VikasCENG/WatechPark/Sensor Specific Code/Camera/image-testing/2020-01-30_0009.jpg

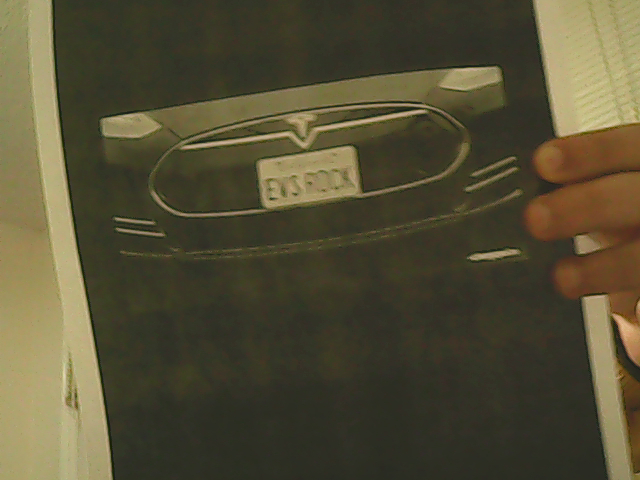
Sensor Specific Code/Camera/image-testing/2020-01-30_0009.jpg
