VikasCENG/WatechPark/README.md

# WatechPark
This is the WatechPark development repository
