VikasCENG/WatechPark/documentation/Seperated report sections/7.1 Finacial update.docx

As of March 3rd, there has not been a major financial change in the project’s cost. In our current situation and due to time limitation, the use of more than one VNCL4010 sensor has been dropped and thus reducing the overall cost by $22.5 USD, but on the other hand, if we had no time constraints then the original overall cost would’ve been increased by $6.95 USD as we would’ve required a TCA9548A I2C multiplexer board to allow us to communicate with multiple VCNL4010 sensors. We also had to switch from a common anode RGB LEDs to common cathode RGB LEDs, which has a very minor impact on the project financially.
