VikasCENG/WatechPark/documentation/Seperated report sections/7.1 Modified Code Files(will not be used).docx

VCNL4010

This sensor code has been simplified to make it easier to look and optimize its usage in the merged program. The status updates from multiple sensors has been removed as well to accommodate the project time limitation and focus on the main functionalities instead of the extra ones.

IR Break Beam Sensor
