VikasCENG/WatechPark/Parking Lot Design/WatechParkLotDesignLaser.pdf

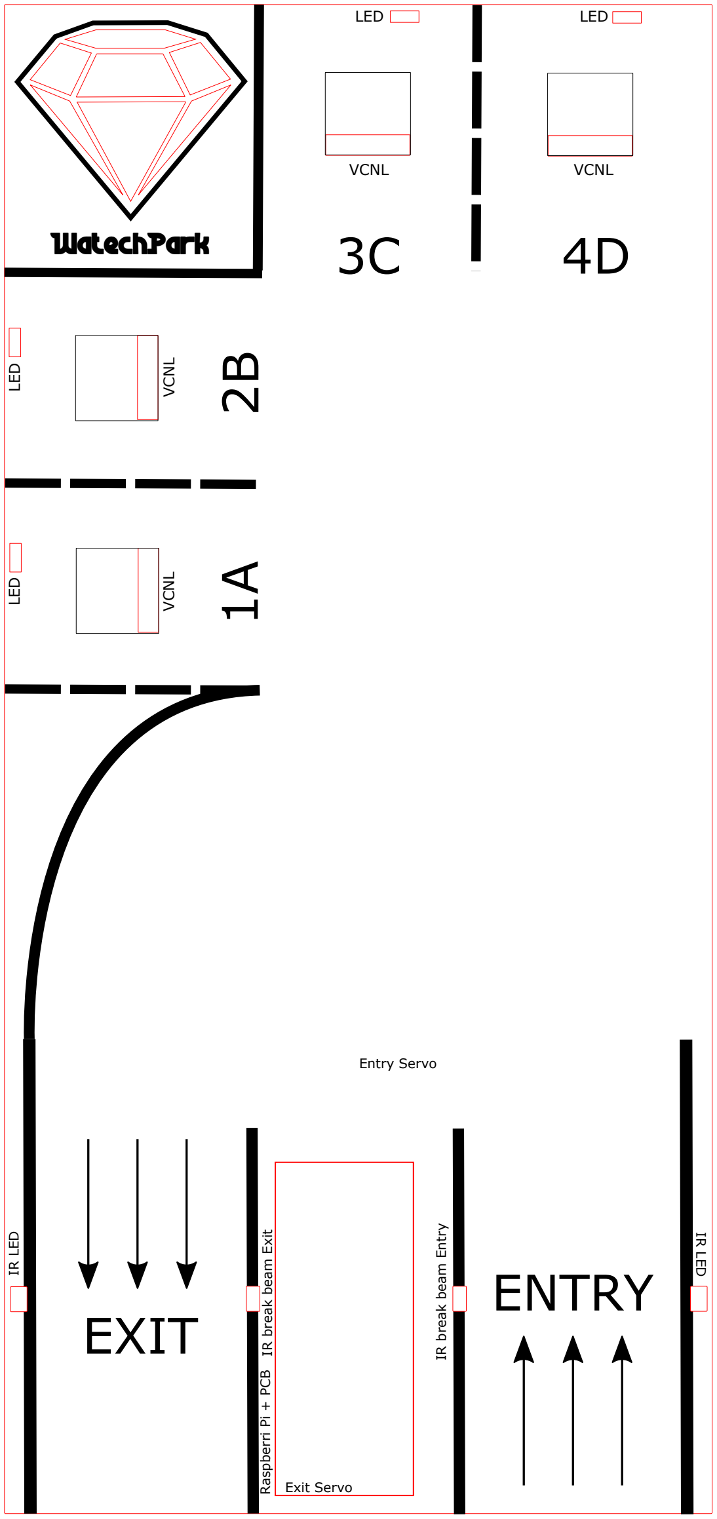
[picture p83: figure]
ENTRY; EXIT; WatechPark; VCNL; LED; Entry Servo; Raspberri Pi + PCB; Exit Servo; IR break beam Entry; IR break beam Exit; IR LED
