VikasCENG/WatechPark/Parking Lot Design/park v2(no logo).pdf

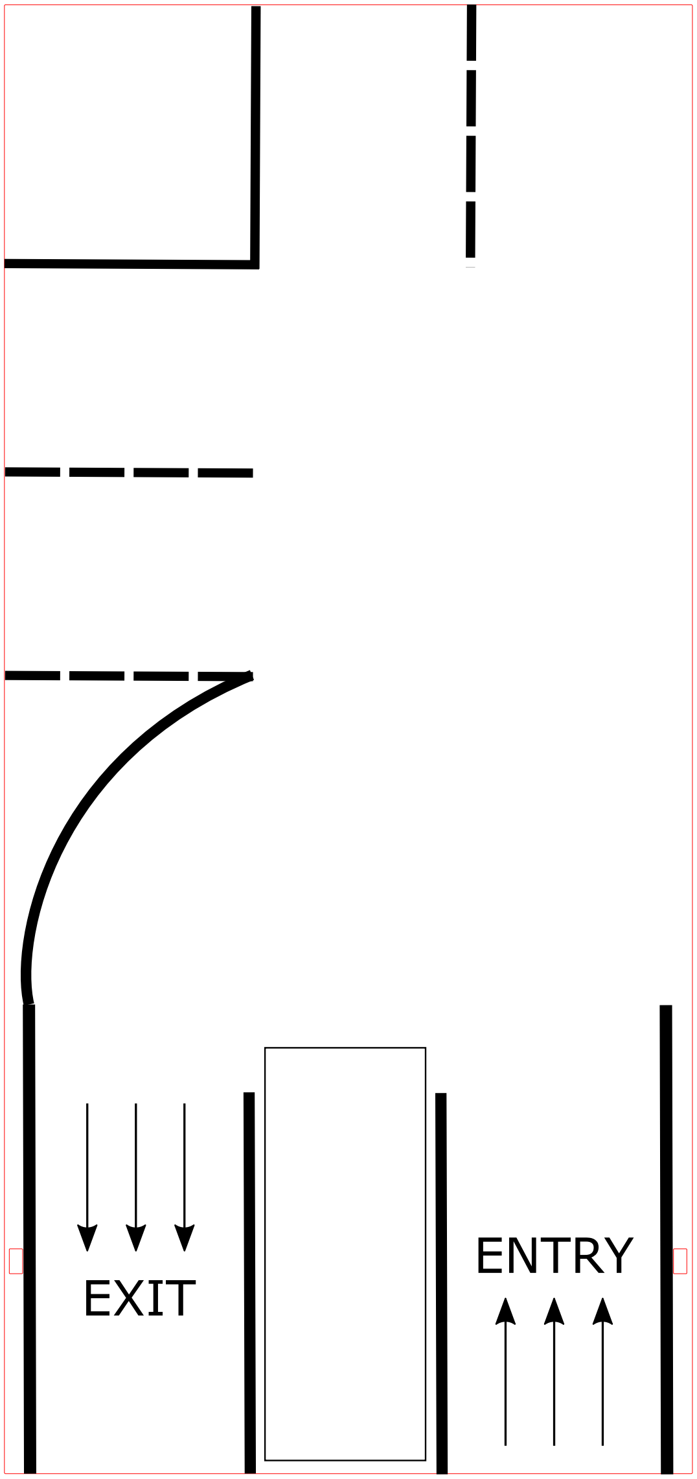
[picture p112: figure]
ENTRY; EXIT
