VikasCENG/WatechPark/documentation/Multimeter/PCB I2C.JPG

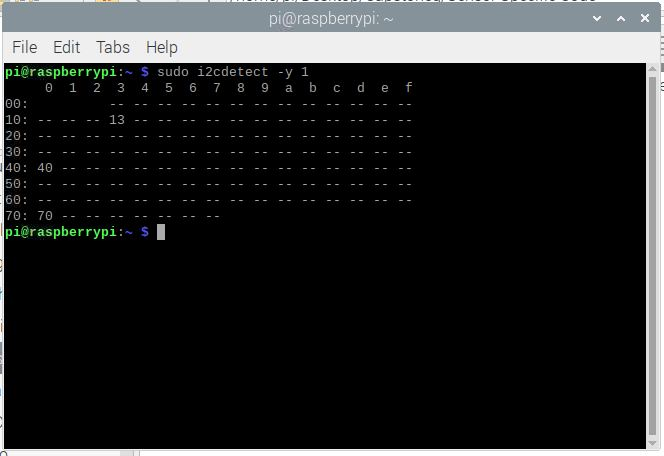
documentation/Multimeter/PCB I2C.JPG
