VikasCENG/WatechPark/documentation/Multimeter/Shortened PCB.JPG

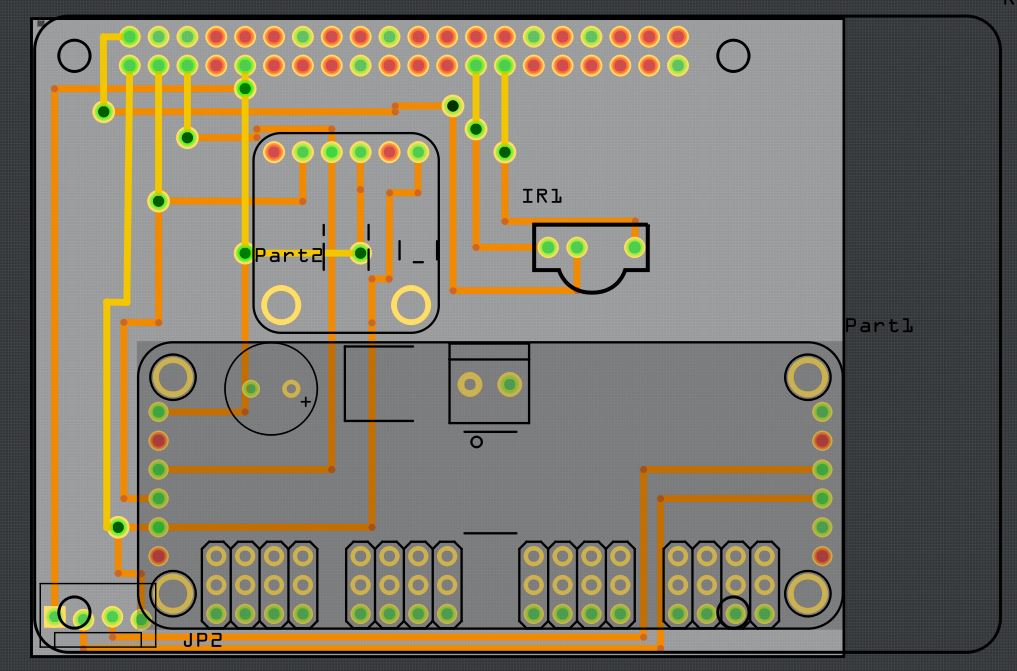
documentation/Multimeter/Shortened PCB.JPG
