VikasCENG/WatechPark/Images/3-3-2020/1.JPG

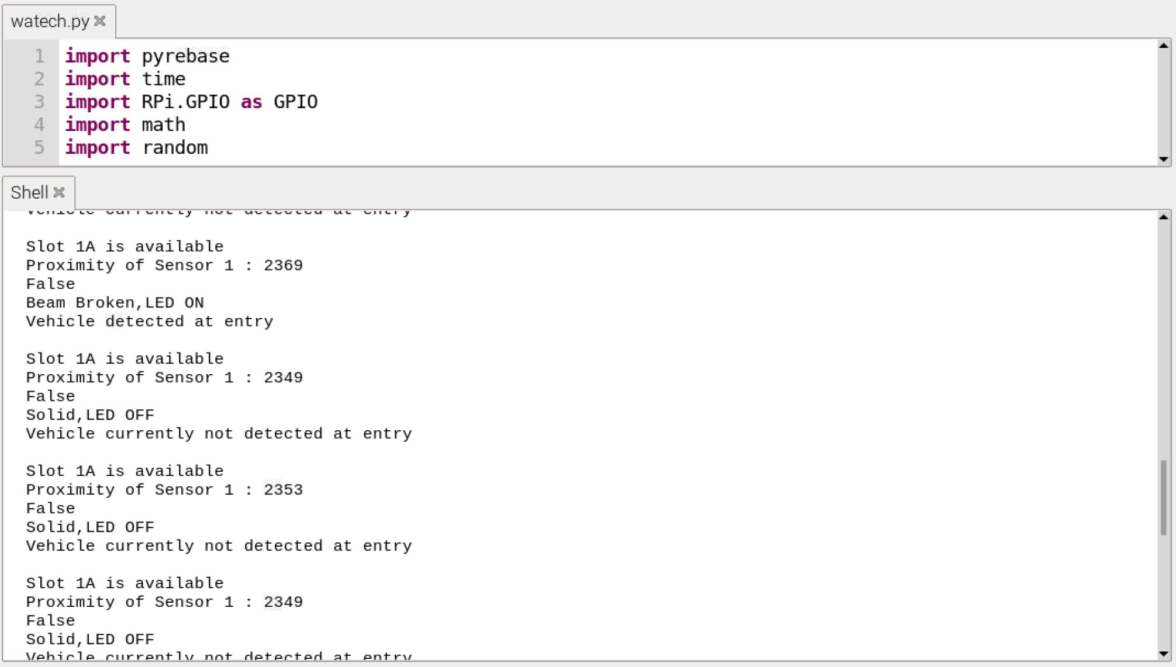
Images/3-3-2020/1.JPG
