VikasCENG/WatechPark/mechanical/WatechParkCaseDesignLaser.png

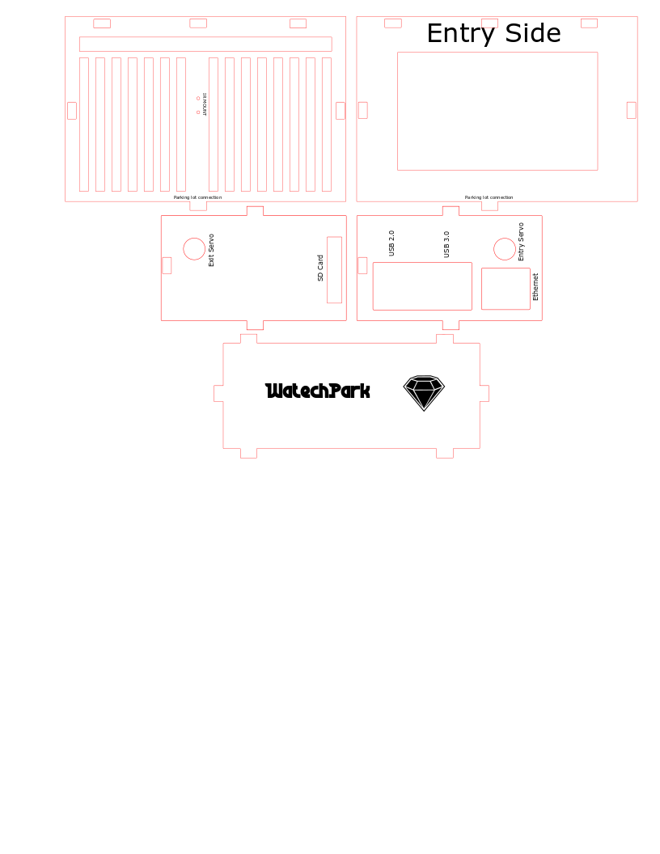
mechanical/WatechParkCaseDesignLaser.png
