VikasCENG/WatechPark/Parking Lot Design/WatechParkLotDesignLaser.png

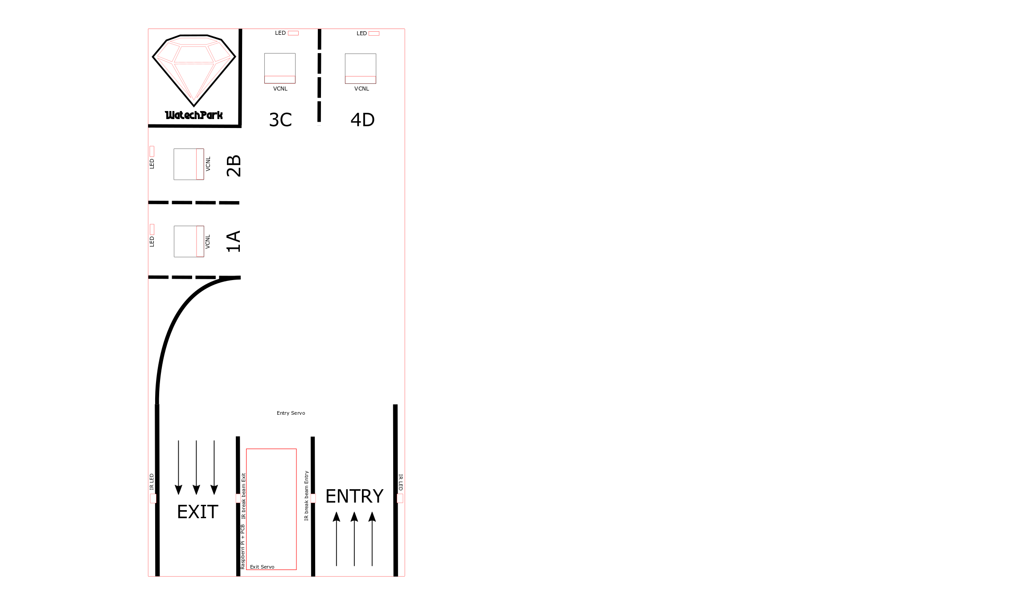
Parking Lot Design/WatechParkLotDesignLaser.png
