VikasCENG/WatechPark/mechanical/WatechParkDesign3D.stl

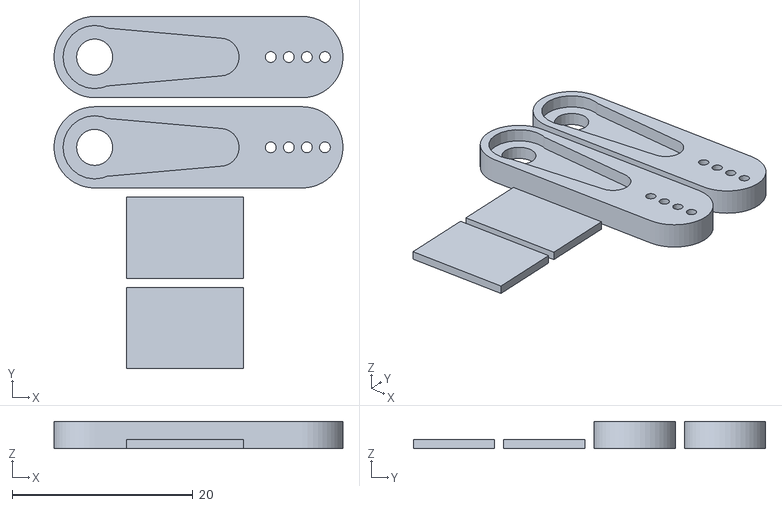
[picture p135: CAD file, 2020-03-11]
mechanical/WatechParkDesign3D.stl
32.0 x 39.0 x 3.00
