VikasCENG/WatechPark/Sensor Specific Code/Camera/image-testing/2020-01-30_0020.jpg

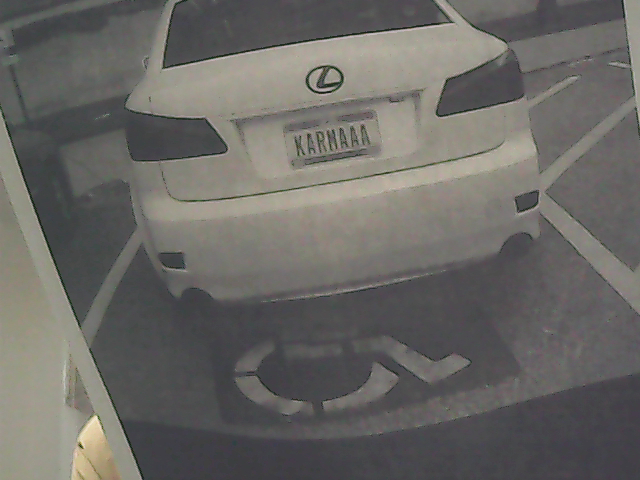
Sensor Specific Code/Camera/image-testing/2020-01-30_0020.jpg
