VikasCENG/WatechPark/Sensor Specific Code/Camera/image-testing/2020-02-05_1340.jpg

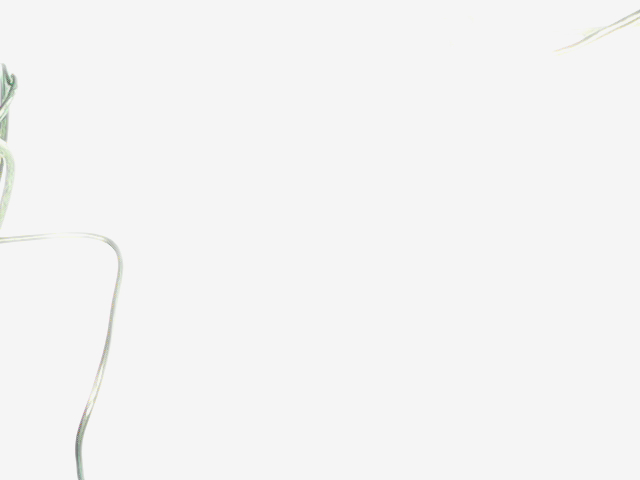
Sensor Specific Code/Camera/image-testing/2020-02-05_1340.jpg
