VikasCENG/WatechPark/Sensor Specific Code/Camera/image-testing/conc1.jpg

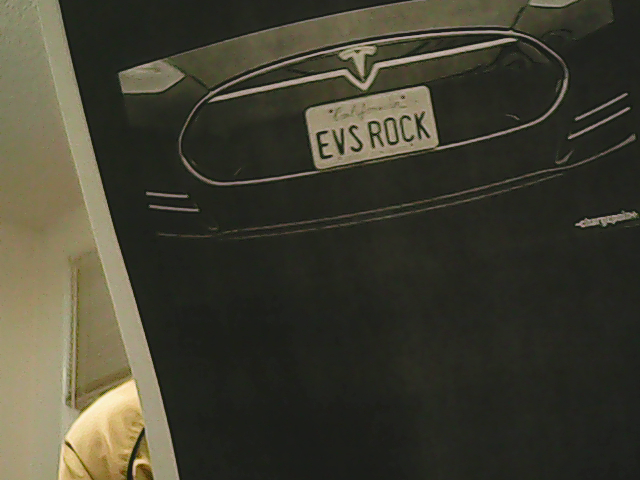
Sensor Specific Code/Camera/image-testing/conc1.jpg
