VikasCENG/WatechPark/Sensor Specific Code/Camera/image-testing/IMG_20200205_133133226.jpg

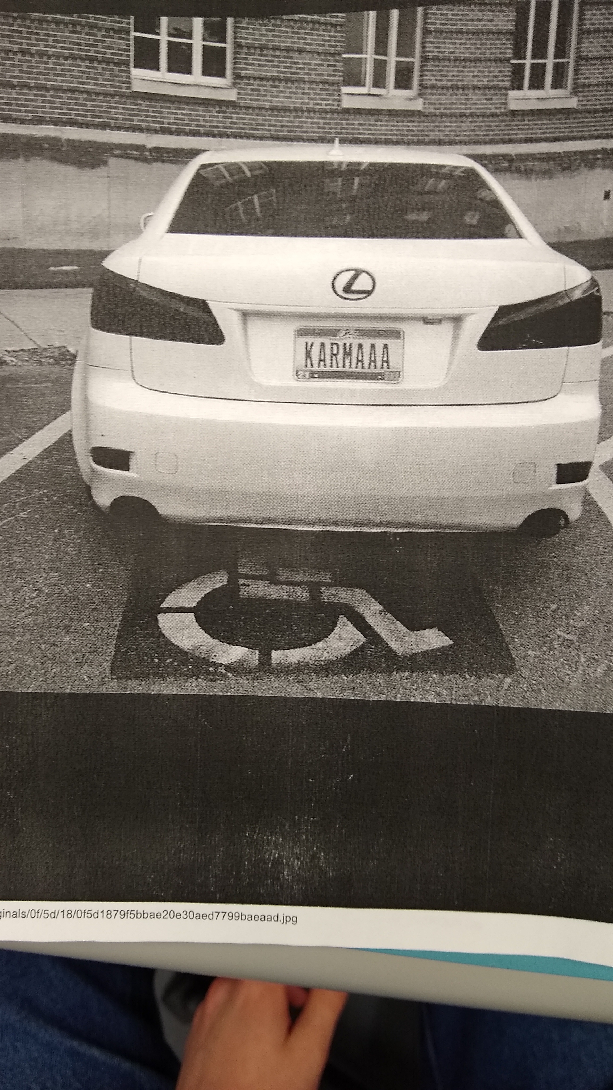
Sensor Specific Code/Camera/image-testing/IMG_20200205_133133226.jpg
