VikasCENG/WatechPark/Sensor Specific Code/Camera/image-testing/IMG_20200205_134101276.jpg

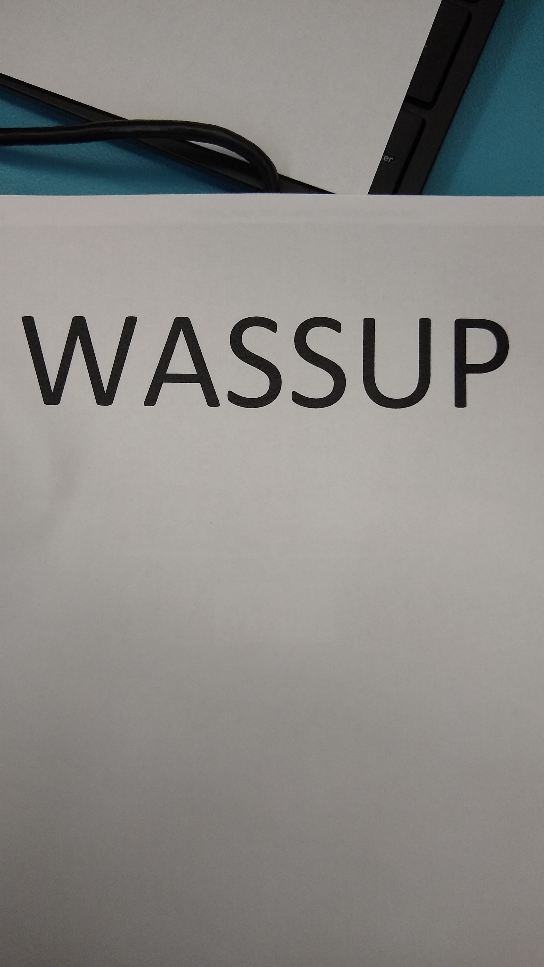
Sensor Specific Code/Camera/image-testing/IMG_20200205_134101276.jpg
