VikasCENG/WatechPark/Sensor Specific Code/Camera/image-testing/labtest2.jpg

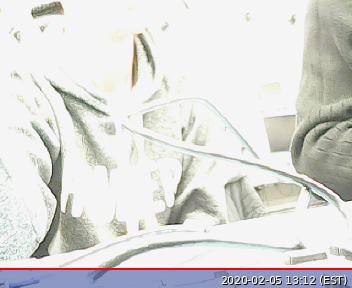
Sensor Specific Code/Camera/image-testing/labtest2.jpg
