VikasCENG/WatechPark/Sensor Specific Code/Camera/image-testing/labtest3.jpg

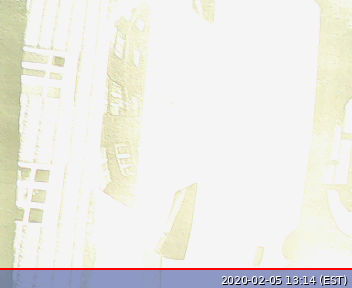
Sensor Specific Code/Camera/image-testing/labtest3.jpg
