VikasCENG/WatechPark/Sensor Specific Code/Camera/image-testing/labtest4.jpg

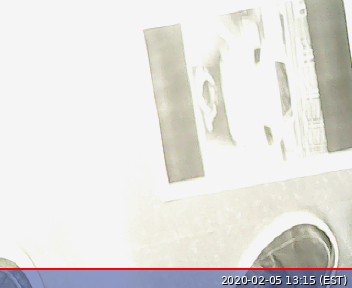
Sensor Specific Code/Camera/image-testing/labtest4.jpg
