VikasCENG/WatechPark/Sensor Specific Code/Camera/image-testing/labtest.jpg

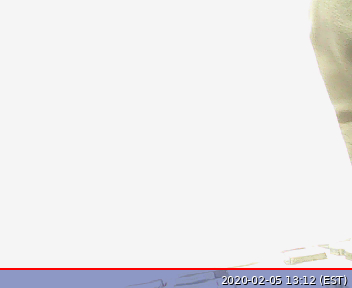
Sensor Specific Code/Camera/image-testing/labtest.jpg
