VikasCENG/WatechPark/Sensor Specific Code/Camera/image-testing/name1.jpg

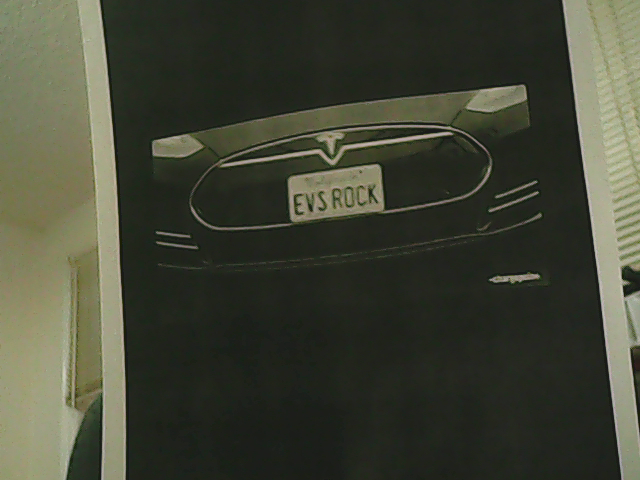
Sensor Specific Code/Camera/image-testing/name1.jpg
