VikasCENG/WatechPark/Sensor Specific Code/Camera/image-testing/test1.jpg

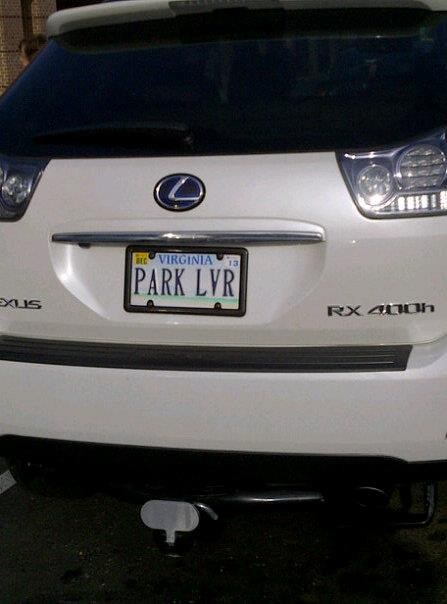
Sensor Specific Code/Camera/image-testing/test1.jpg
