VikasCENG/WatechPark/(threads)

Thread 1 (2020-02-10):

Camera Licence Plate Detection

spacen00dle, 2020-02-10:
Current Licence plate reader software is not very reliable and is having trouble detecint the "contours" of the licence plate in order to read the text

The other licence plate reader option that was provided by other student has not yet been tested, but early preview have shown that it reads all the text within an image, which can be problematic as we need it to only read the licence plate option

An external and last measure solution could be to replace the licence plate reading idea with a QR code that could be given to each customer

Thread 2 (2020-02-10):

Servo Motors Placement

spacen00dle, 2020-02-10:
With the current size limitations, we barely have any space to spare for the part placement.
I will use the term "station" to refer to the raspberry pi and finalized PCB" as they will be combined together

**Here are the current known limitations to me:**

- Servo motors cannot be placed infront and behind the Station because that will take alot of space and prevent the cars from reaching half of the parking spots

- Placing the Station Vertically (USB ports Facing Upword) to save horizontal space is not possible because the station will exceede the vertical space limitation which is 7.5cm

- If the raspberry pi is to be seperated from the PCB and placed somewhere else, a USB extention will need to be introduced to connect the Camera, while keeping in mind that the Camera will utilize the verticle space we have, thus preventing us from placing the raspberry pi under the parking lot

**Possible Solutions:**

- One servo motor can be placed on the left side of the exit and not in the middle near the station, thus saving some space for the other servo motor to be placed infront of the station.
_this solution works but will not look nice is it is not uniform or symmatric_

- the station enclosure will have to be designed to house the raspberry pi, PCB, and the servo motors all in one package with a length of ~9cm maximum
_to be investigated_
