VikasCENG/WatechPark/mechanical/WatechParkCaseDesignLaser.pdf

# Entry Side

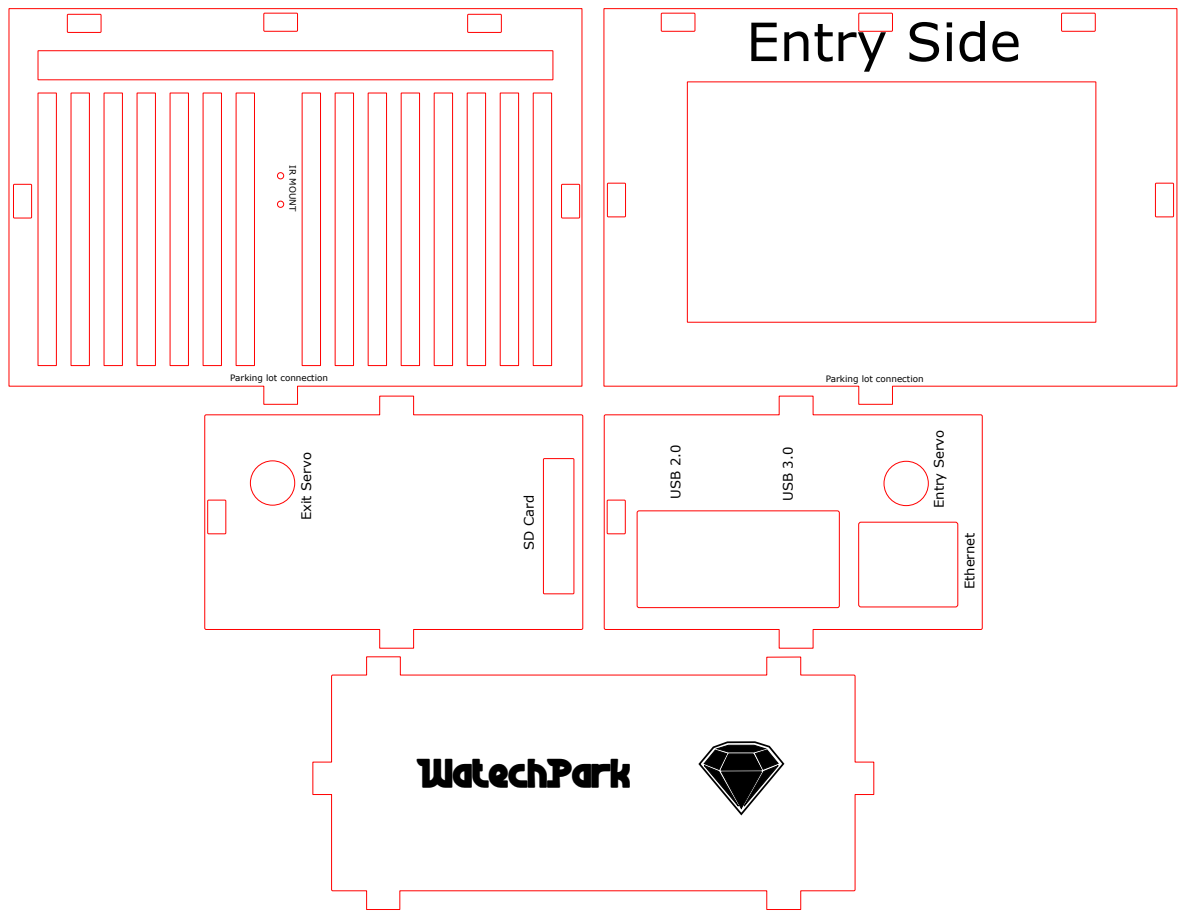
[picture p158: page 1]
IR MOUNT; Parking lot connection; Exit Servo; USB 2.0; USB 3.0; Entry Servo; Ethernet

WatechPark SD Card
