VikasCENG/WatechPark/(list of files, drawings)

Other design files:
electronics/Final PCB v1.fzz
electronics/Final PCB v2.fzz
electronics/Final PCB v3(Shortened).fzz
electronics/IRBREAKBEAMSENSOR.fzz
electronics/Vikas_VCNL4010ProximityPCBFINAL.fzz
