VikasCENG/WatechPark/(commit log)

2019-11-19 Week 11 - update before milestone 3 submission(not done)
    [app_bar_main_menu.xml]
2019-11-20 Week 11 - Milestone 3 submission(login/reg database authentication part complete
    - able to read/write data to Firebase, read back realtime data, with realtime changes being applied to the app UI(AccountMananagement screen)
    - designed support for portrait/landscape mode(for all screens)
    - store image(profile image) on the storage(cloud) and the device.(able to to store data to the server, and read it back to the app.
    Next Steps:
    - work on payment/order histroy screens add in the functionality and write data to Firebase,retrieve Order History info through the 'Orders ' table.
    - work on all other screens to follow design guidelines layed out before next collab meeting.
    - finish all features and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
    [app_bar_main_menu.xml]
2019-12-02 new update(still not done fully)
    [app_bar_main_menu.xml]
2019-12-08 Pre-final commit - have to finish adding french for all strings
    [app_bar_main_menu.xml]
2020-02-09 Updating Repo with what is currently worked on
2020-02-11 VCNL4010 PCB Design(Fall 2019)
    [Vikas_VCNL4010ProximityPCBFINAL.fzz]
2020-02-12 Final PCB v1
    [Final PCB v1.fzz]
2020-02-19 Breadboard/Independant PCBs Status Submission
2020-02-19 Parking Spot and PCB update
    *. Parking spot layout has been changed from Landscape to Portrait to allow for more space for the controlling station
    *. The PCB design for the final prototype has been updated and routed as needed, there will be a need for more changes but for now this should be ready to be tested and should give an idea of how much space we will have for the external cables to be routed and how it would look on the raspberry pi
    [Final PCB v2.fzz]
2020-02-19 Wrong pin connected to the VCNL4010
    [Final PCB v2.fzz]
2020-02-19 via change possiblity
    [Final PCB v2.fzz]
2020-02-23 Updated code(Parking Spot test with Sensor 1)
2020-02-24 Updated code(Proximity Sensor 1 Test)
2020-02-25 PCB and parking spot update
    PCB has been updated with the proper Via holes
    Parking lot has been updated with a modified logo for laser cutting and parking spot number tags
    [Final PCB v2.fzz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]
2020-02-28 new pcb design to resolve the usb conflict
    [Final PCB v3(Shortened).fzz]
2020-03-11 Submission update 3.2.4
    PCB soldering and designing update
2020-03-11 PCB Submission
2020-03-11 Final PCB Design
2020-03-11 Final PCB Submission
2020-03-11 Finalized 3.2.4
    Ready for PCB submission
2020-03-11 3D print and case small change
    [SG90ServoHornExtender.stl]
2020-03-12 Finalized 3.2.4 PCB Submission
2020-03-22 Test push (Elias)
    [app_bar_main_menu.xml]
2020-03-22 Branch prepare
    [app_bar_main_menu.xml]
2020-03-22 Master branch prepare for merge
    [app_bar_main_menu.xml]
2020-03-31 Enterprise Wireless and Unit Testing Documentation
2020-04-06 Poster added Enclosure
    Enclosure poster description added to poster
2020-04-06 moved to mechanical
    [WatechParkDesign3D.stl]
2020-04-07 pre-final poster update(pcb/firmware WIP)
2020-04-07 Enclosure and Parking Lot redesign
2020-04-07 Laser Designs presentation ready
2020-04-07 pre-final poster update(replaced case/lot screens)
2020-04-08 (fixed aim,conclusion,added 3D printed part)
2020-04-08 poster update(fixed aim,con,enclosure section)
2020-04-08 pre-final poster update(fixed enclosure section)
